cyrozap/PrusaMendel/metric-prusa-lm8uu/x-carriage.stl

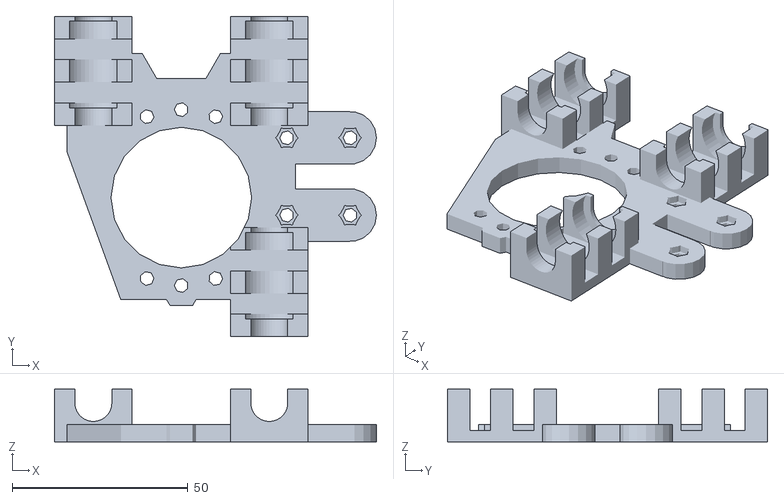
[picture p14: CAD file, 2011-12-08]
metric-prusa-lm8uu/x-carriage.stl
91.6 x 91.1 x 15.0
