cyrozap/PrusaMendel/metric-prusa/coupling.stl

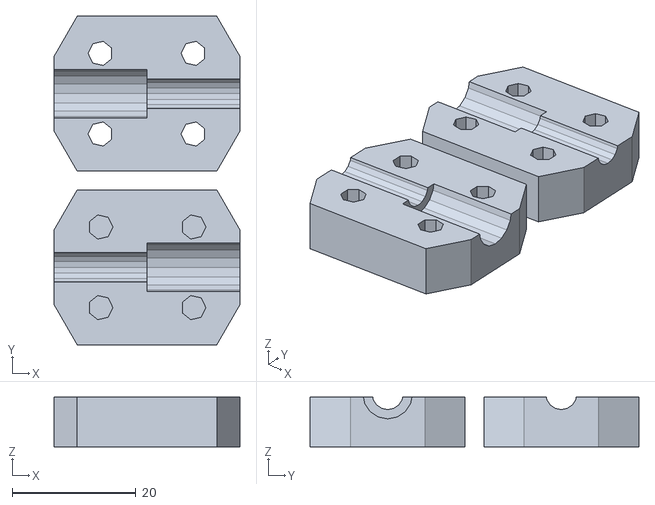
[picture p15: CAD file, 2011-12-08]
metric-prusa/coupling.stl
30.0 x 53.0 x 8.00
