cyrozap/PrusaMendel/metric-prusa/filament_guide.stl

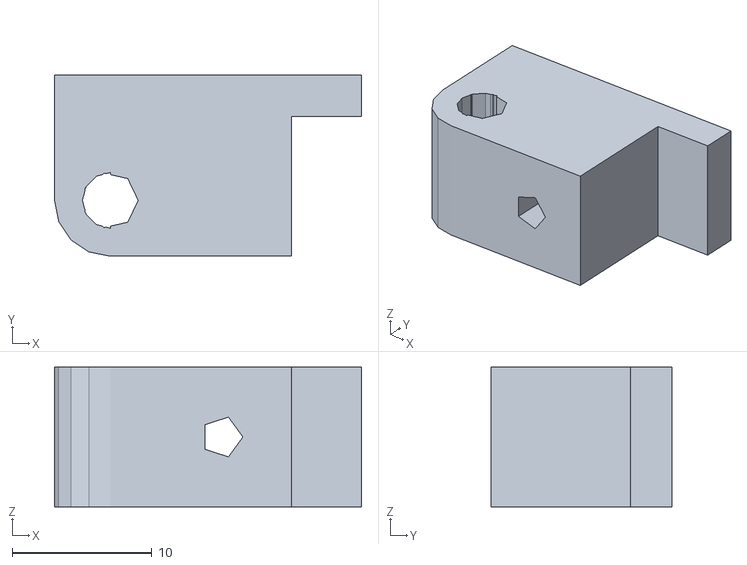
[picture p16: CAD file, 2011-12-08]
metric-prusa/filament_guide.stl
22.0 x 13.0 x 10.0
