cyrozap/PrusaMendel/metric-prusa/y-bushing.stl

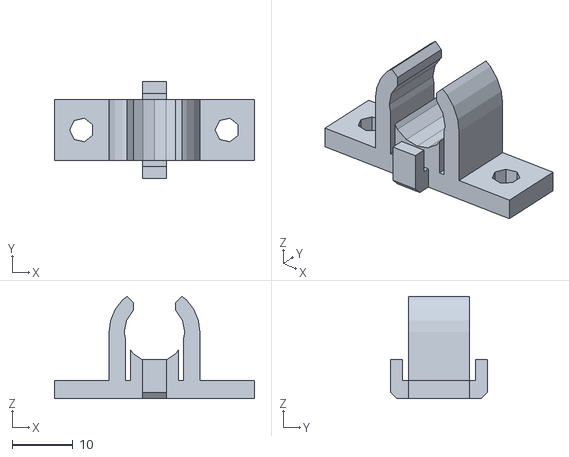
[picture p17: CAD file, 2011-11-22]
metric-prusa/y-bushing.stl
33.0 x 16.0 x 16.9
