cyrozap/PrusaMendel/metric-prusa-lm8uu/sanguinololu-holder.stl

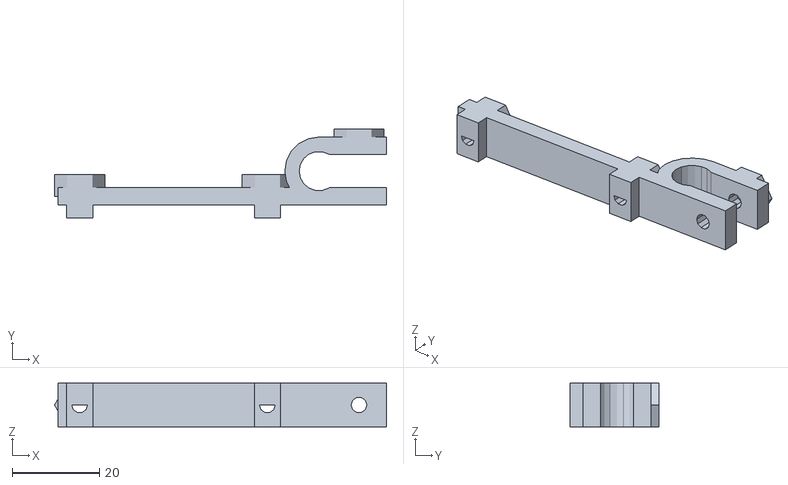
[picture p18: CAD file, 2011-11-22]
metric-prusa-lm8uu/sanguinololu-holder.stl
76.1 x 20.5 x 10.0
