cyrozap/PrusaMendel/metric-prusa-lm8uu/bearing-guide.stl

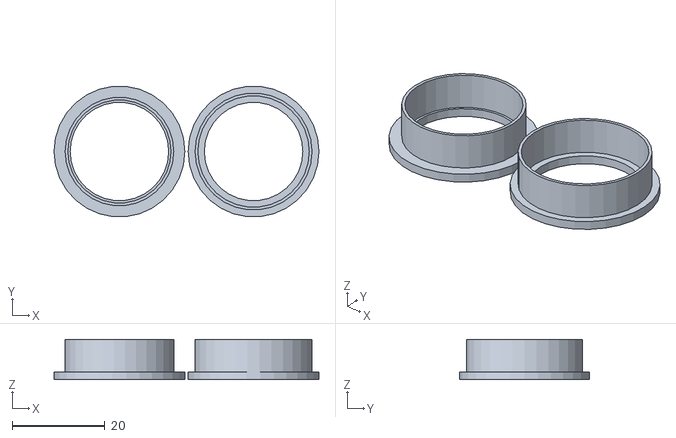
[picture p19: CAD file, 2011-11-22]
metric-prusa-lm8uu/bearing-guide.stl
57.3 x 28.1 x 8.70
