cyrozap/PrusaMendel/metric-prusa/wade-big.stl

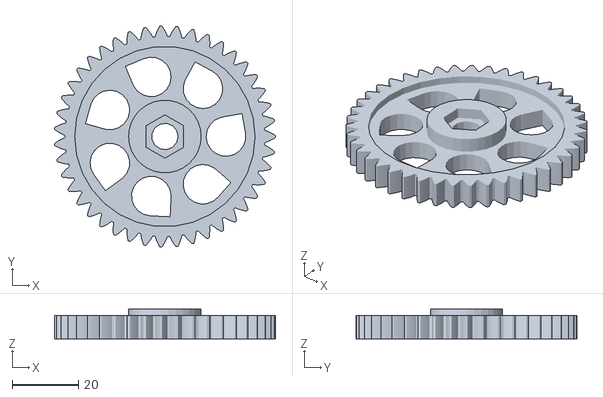
[picture p20: CAD file, 2011-11-22]
metric-prusa/wade-big.stl
66.9 x 67.0 x 9.00
