cyrozap/PrusaMendel/metric-prusa-lm8uu/frame-vertex.stl

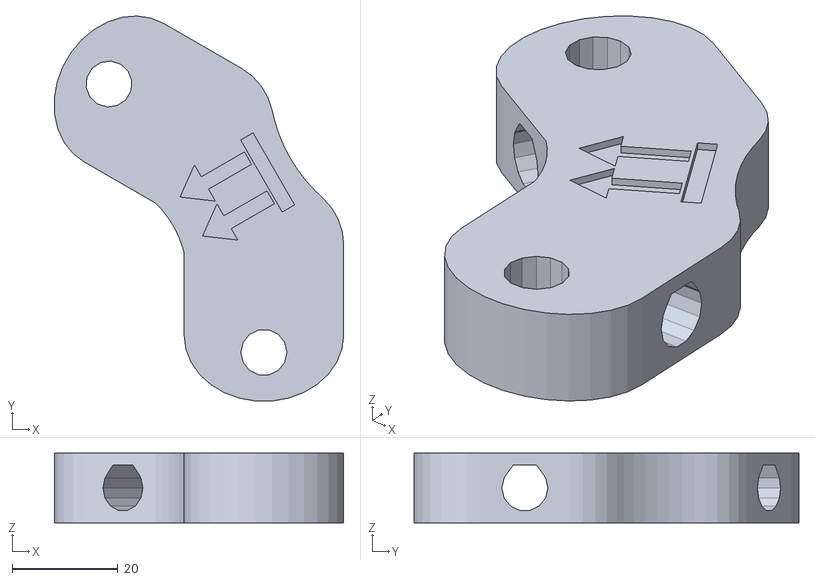
[picture p21: CAD file, 2011-11-22]
metric-prusa-lm8uu/frame-vertex.stl
54.7 x 72.7 x 13.2
