cyrozap/PrusaMendel/metric-prusa/z-motor-mount.stl

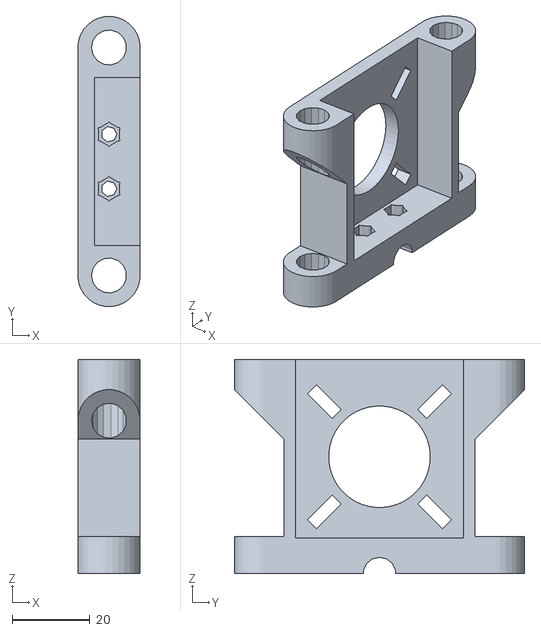
[picture p22: CAD file, 2011-11-22]
metric-prusa/z-motor-mount.stl
16.0 x 74.4 x 55.0
