cyrozap/PrusaMendel/metric-prusa/x-end-motor.stl

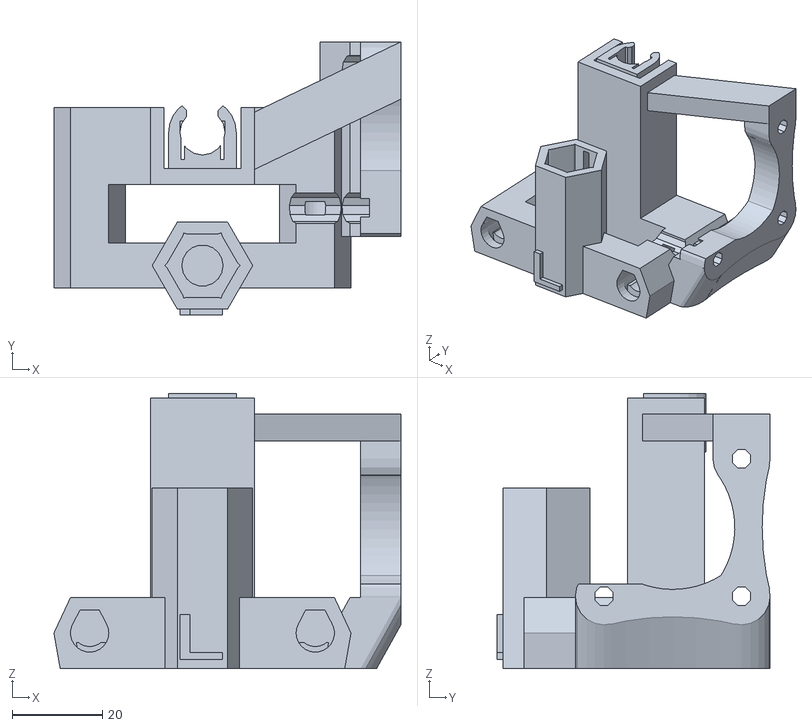
[picture p23: CAD file, 2011-11-22]
metric-prusa/x-end-motor.stl
76.9 x 60.6 x 61.0
