cyrozap/PrusaMendel/metric-prusa/bar-clamp.stl

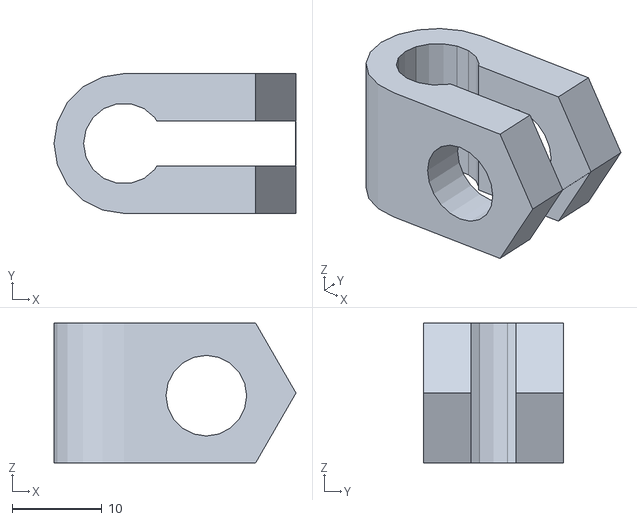
[picture p25: CAD file, 2011-11-22]
metric-prusa/bar-clamp.stl
27.0 x 15.6 x 15.6
