cyrozap/PrusaMendel/metric-prusa-lm8uu/pulley.stl

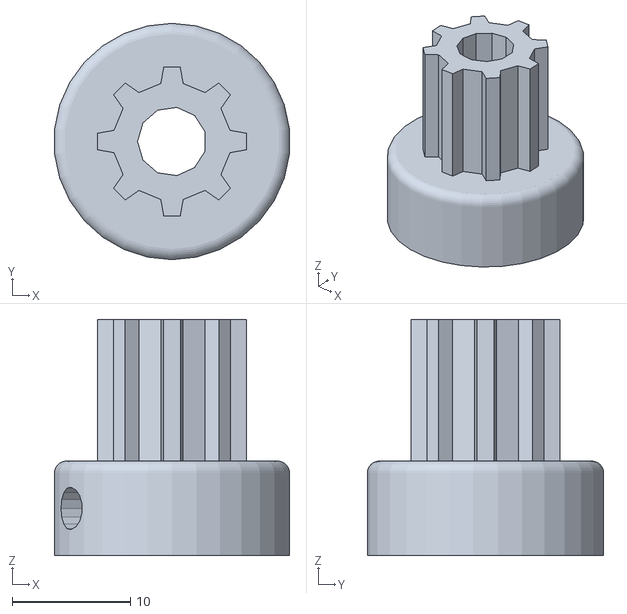
[picture p26: CAD file, 2011-11-22]
metric-prusa-lm8uu/pulley.stl
19.9 x 20.0 x 20.0
