cyrozap/PrusaMendel/metric-prusa/ybrac-t.stl

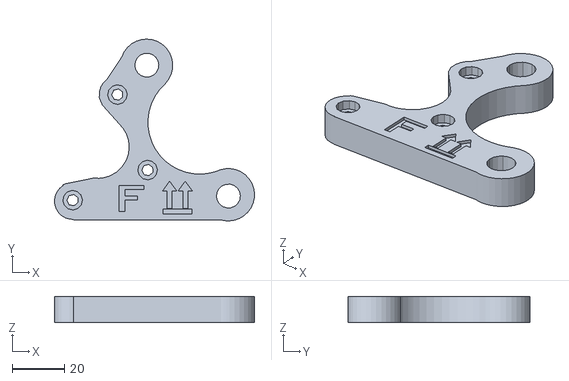
[picture p27: CAD file, 2011-11-22]
metric-prusa/ybrac-t.stl
76.4 x 69.4 x 10.0
