cyrozap/PrusaMendel/metric-prusa-lm8uu/rod-clamp.stl

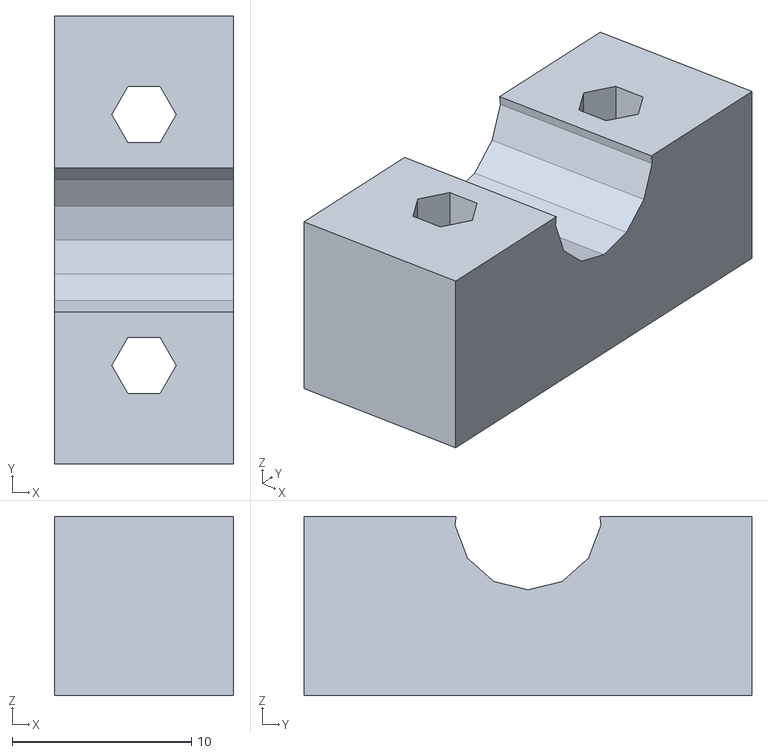
[picture p28: CAD file, 2011-11-22]
metric-prusa-lm8uu/rod-clamp.stl
10.0 x 25.0 x 10.0
