cyrozap/PrusaMendel/metric-prusa/wade-small.stl

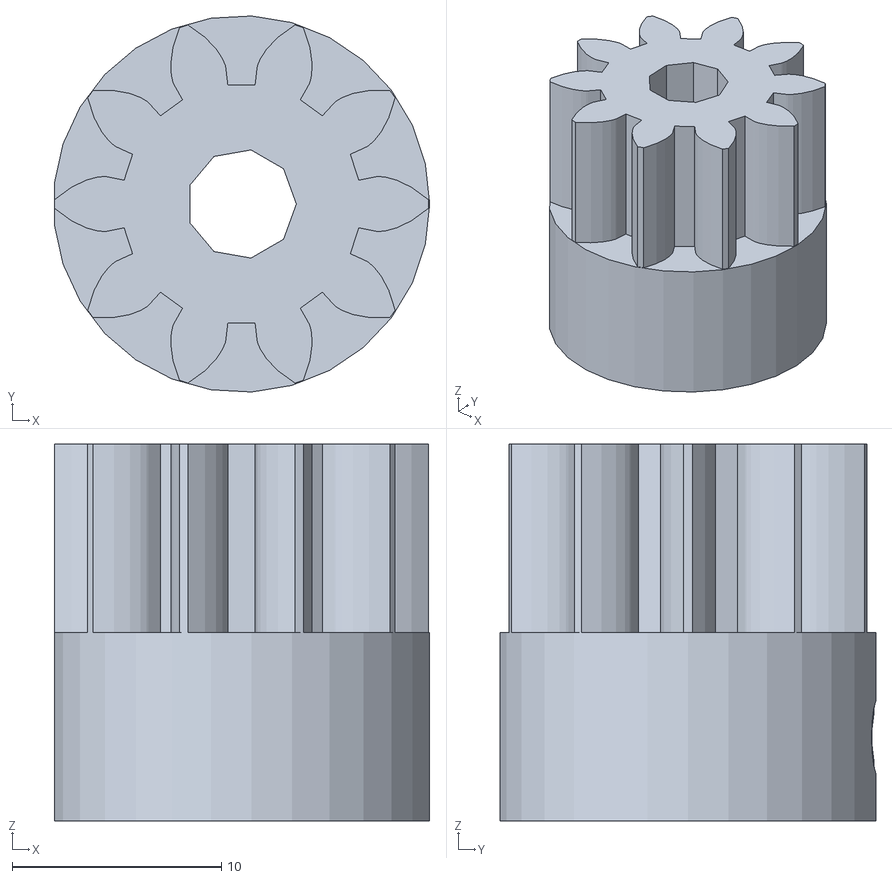
[picture p29: CAD file, 2011-11-22]
metric-prusa/wade-small.stl
17.9 x 18.0 x 18.0
