cyrozap/PrusaMendel/metric-prusa-lm8uu/endstop-holder.stl

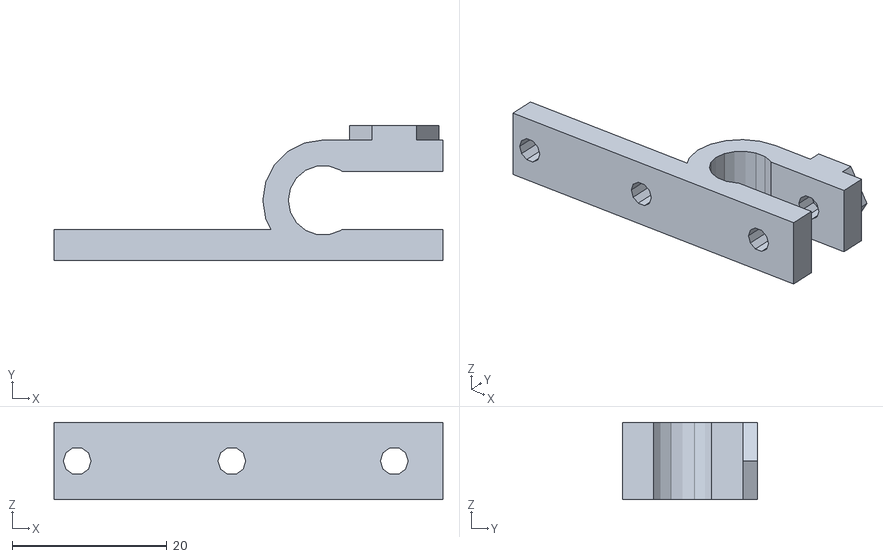
[picture p30: CAD file, 2011-11-22]
metric-prusa-lm8uu/endstop-holder.stl
50.3 x 17.5 x 10.0
