cyrozap/PrusaMendel/metric-prusa/frame-vertex-foot.stl

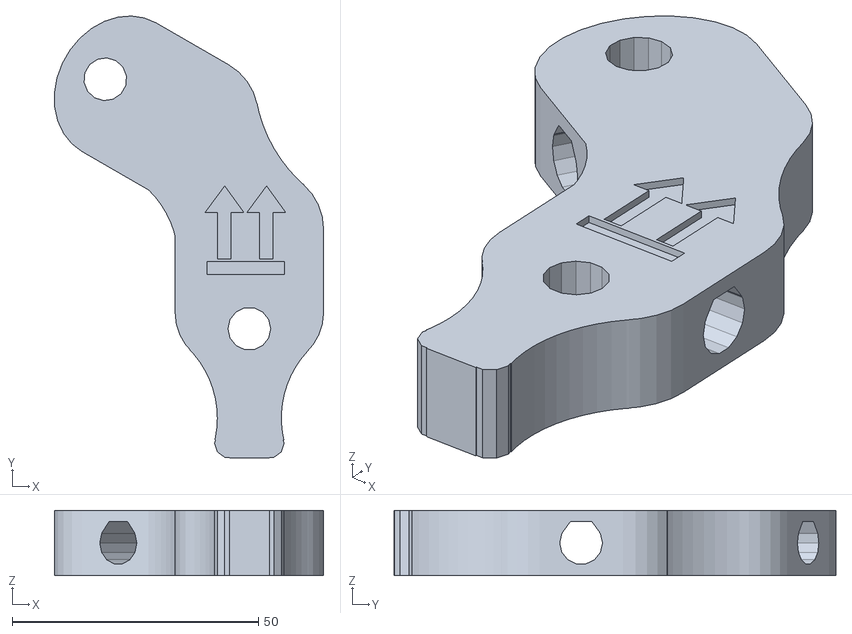
[picture p31: CAD file, 2011-11-22]
metric-prusa/frame-vertex-foot.stl
54.7 x 89.8 x 13.2
