cyrozap/PrusaMendel/metric-prusa-lm8uu/x-end-idler.stl

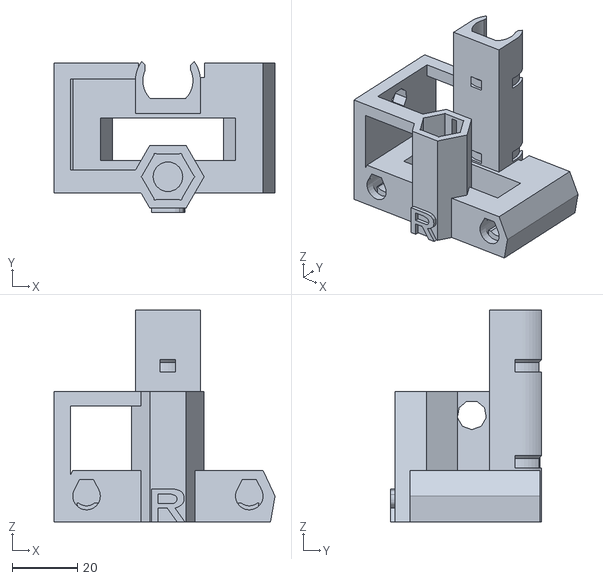
[picture p32: CAD file, 2011-11-22]
metric-prusa-lm8uu/x-end-idler.stl
67.9 x 46.4 x 65.0
