cyrozap/PrusaMendel/metric-prusa-lm8uu/x-end-motor.stl

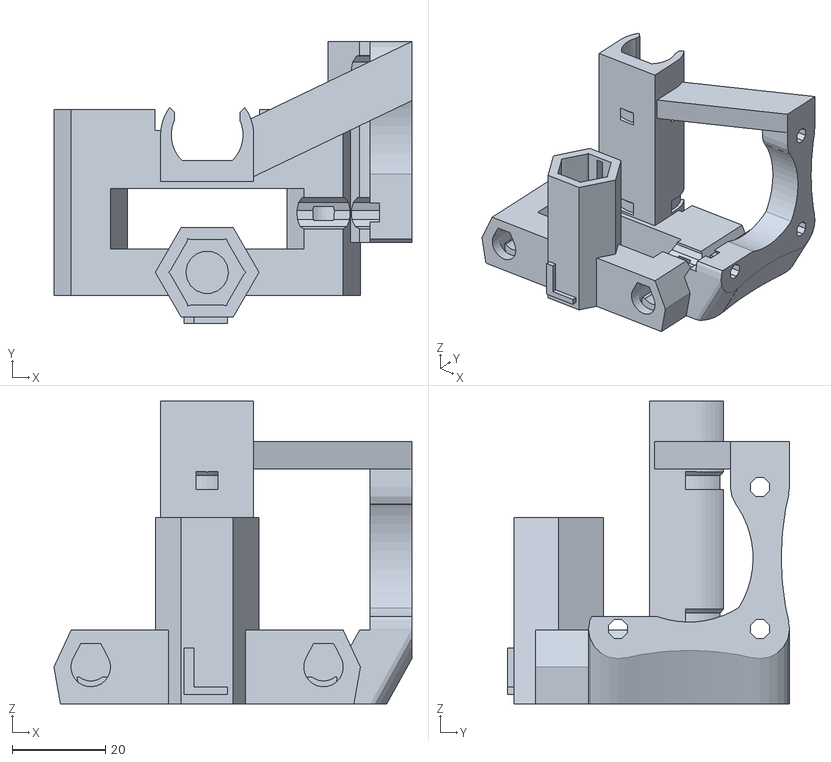
[picture p33: CAD file, 2011-11-22]
metric-prusa-lm8uu/x-end-motor.stl
76.9 x 60.6 x 65.0
