cyrozap/PrusaMendel/metric-prusa/x-carriage.stl

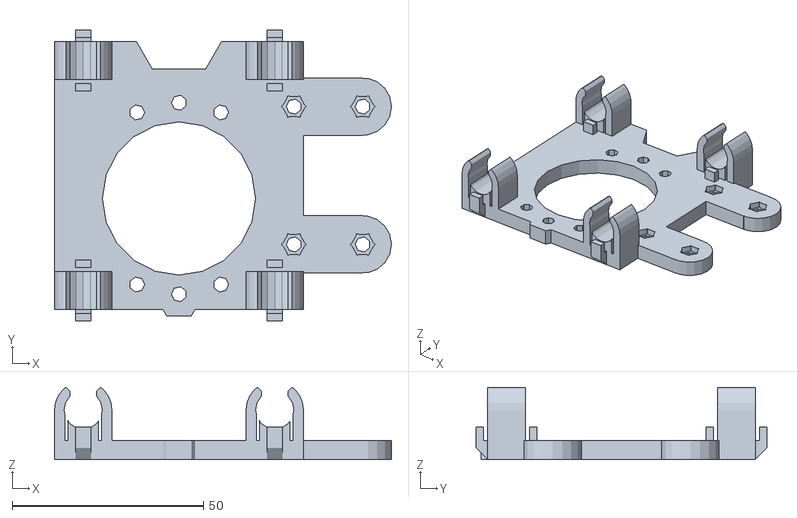
[picture p34: CAD file, 2011-11-22]
metric-prusa/x-carriage.stl
88.0 x 76.0 x 18.9
