cyrozap/PrusaMendel/metric-prusa/x-end-idler.stl

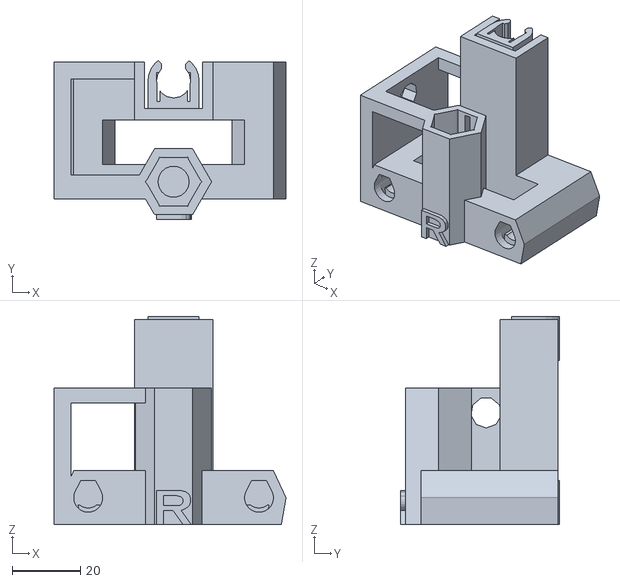
[picture p35: CAD file, 2011-11-22]
metric-prusa/x-end-idler.stl
67.9 x 46.4 x 61.0
