cyrozap/PrusaMendel/(list of files, cad)

Other CAD files:
metric-prusa-lm8uu/filament_guide.stl
metric-prusa-lm8uu/belt-clamp-nut-holder.stl
metric-prusa/belt-clamp-nut-holder.stl
