cyrozap/PrusaMendel/(commit log)

2011-11-22 got rid of build plates, generated individual files, spellchecked documentation
    [bar-clamp.stl, bearing-guide.stl, belt-clamp-nut-holder.stl, coupling.stl, endstop-holder.stl, frame-vertex-foot.stl, frame-vertex.stl, mendel-plate-1.scad]
2011-12-08 added the filament guide, modified the couplings to fit my steppers
    [coupling.scad, coupling.stl, filament_guide.stl, x-carriage.stl]
